hari4579/precharge/final_pre/final_pre.kicad_pcb

## KiCad design final_pre/final_pre.kicad_pcb (2026-10-30)

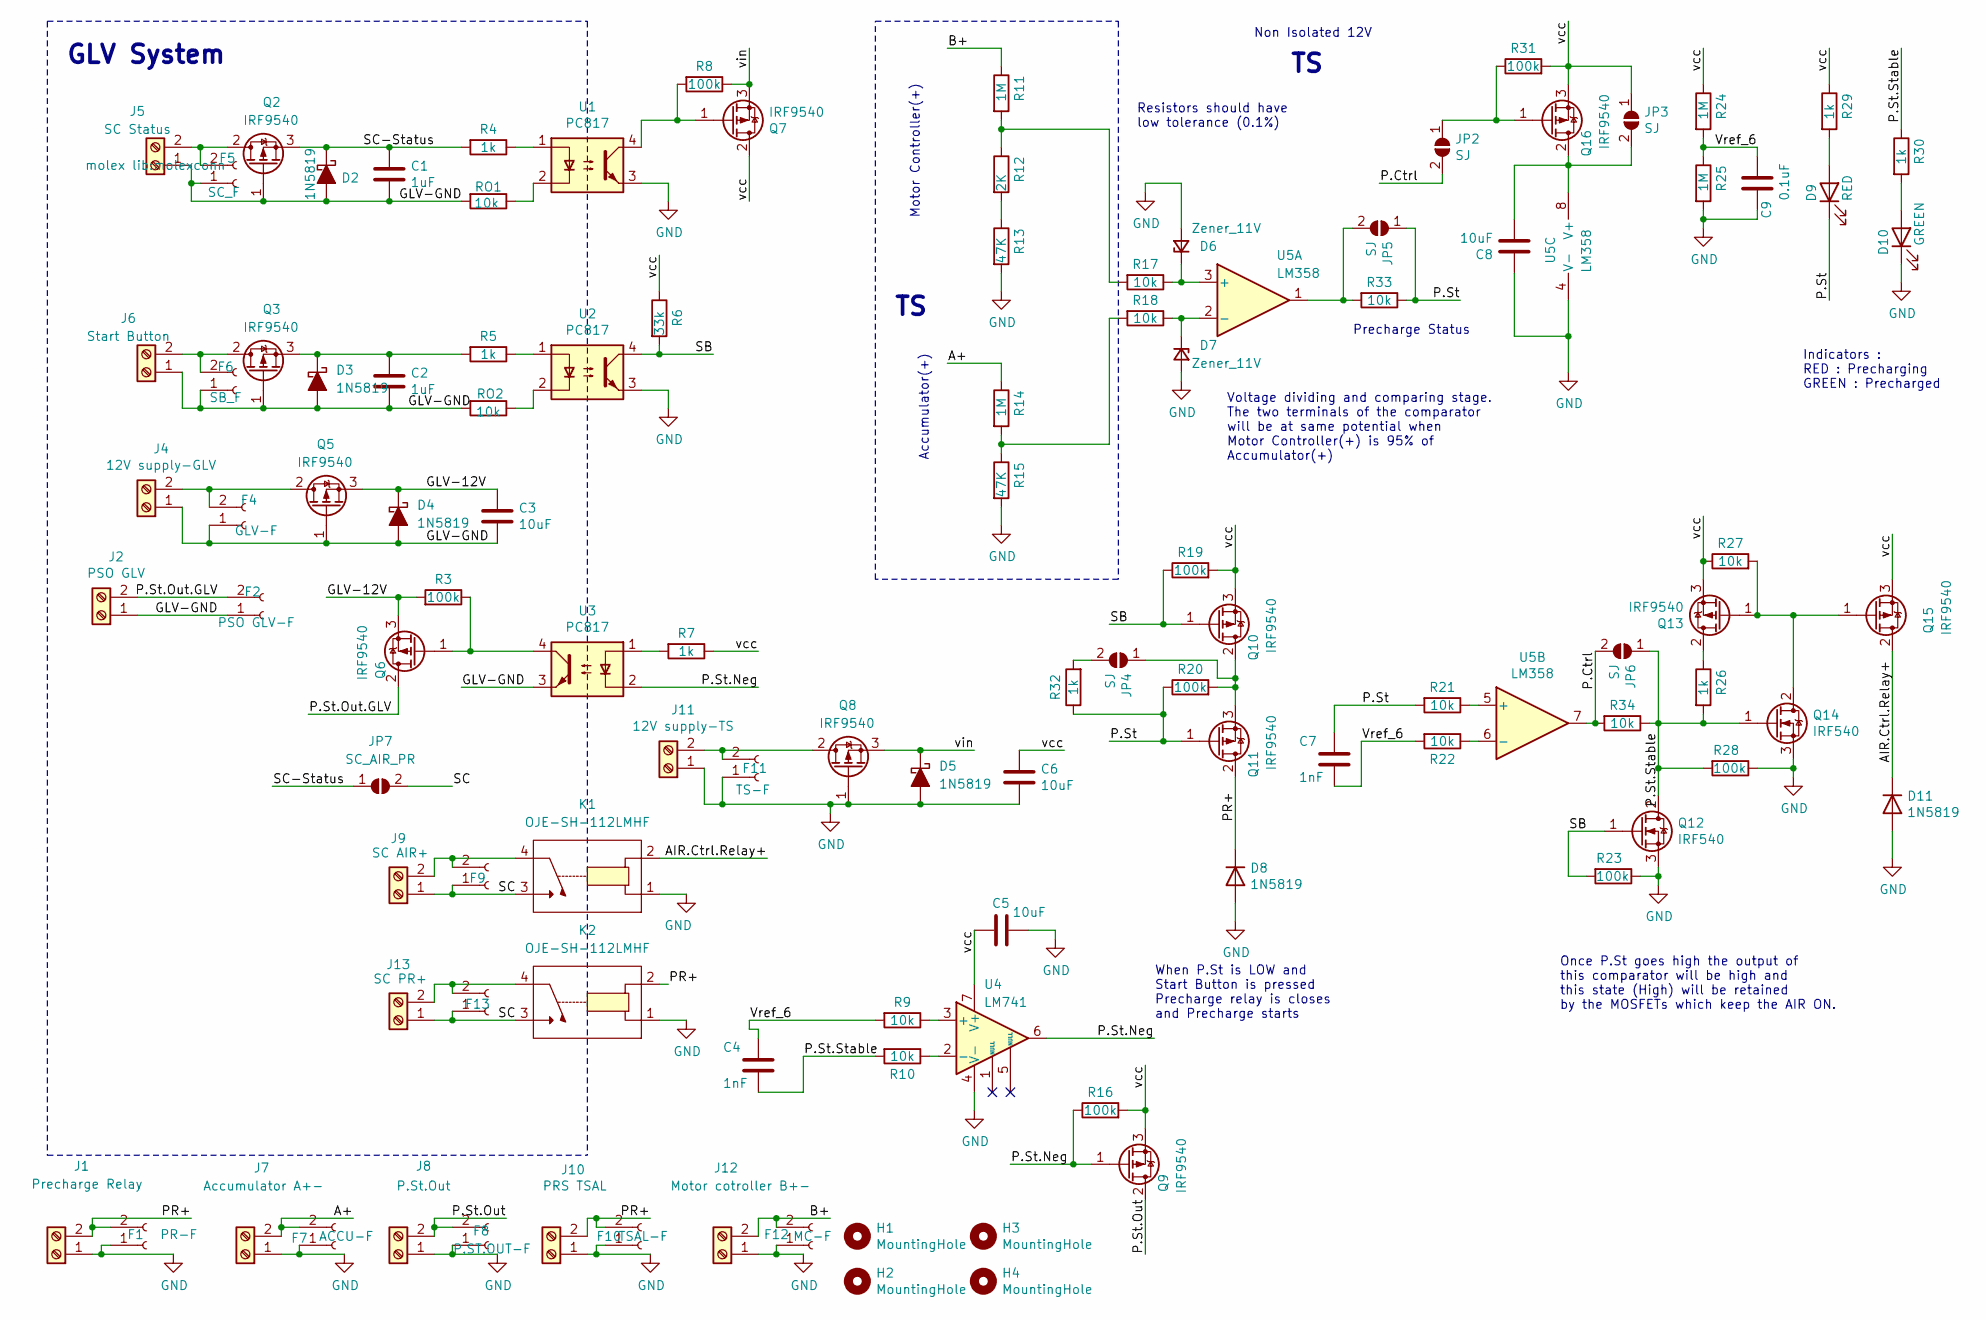
[picture p1: schematic final_pre.kicad_sch]

Parts:
C1, C2: 1uF; CP_Radial_D5.0mm_P2.50mm
C3, C5, C6, C8: 10uF; CP_Radial_D5.0mm_P2.50mm
C4, C7: 1nF; CP_Radial_D5.0mm_P2.50mm
C9: 0.1uF; CP_Radial_D5.0mm_P2.50mm
D2, D3, D4, D5, D8, D11: 1N5819; D_DO-41_SOD81_P10.16mm_Horizontal
D6, D7: Zener_11V; D_DO-41_SOD81_P10.16mm_Horizontal
D9: RED; LED_D5.0mm
D10: GREEN; LED_D5.0mm
F1: PR-F; PinSocket_1x02_P2.54mm_Vertical
F2: PSO GLV-F; PinSocket_1x02_P2.54mm_Vertical
F4: GLV-F; PinSocket_1x02_P2.54mm_Vertical
F5: SC_F; PinSocket_1x02_P2.54mm_Vertical
F6: SB_F; PinSocket_1x02_P2.54mm_Vertical
F7: ACCU-F; PinSocket_1x02_P2.54mm_Vertical
F8: P.ST.OUT-F; PinSocket_1x02_P2.54mm_Vertical
F9: SC AIR-F; PinSocket_1x02_P2.54mm_Vertical
F10: TSAL-F; PinSocket_1x02_P2.54mm_Vertical
F11: TS-F; PinSocket_1x02_P2.54mm_Vertical
F12: MC-F; PinSocket_1x02_P2.54mm_Vertical
F13: PC AIR-F; PinSocket_1x02_P2.54mm_Vertical
H1, H2, H3, H4: MountingHole; MountingHole_3mm
J1: Precharge Relay; molexconn
J2: PSO GLV; molexconn
J4: 12V supply-GLV; molexconn
J5: SC Status; molexconn
J6: Start Button; molexconn
J7: Accumulator A+-; molexconn
J8: P.St.Out; molexconn
J9: SC AIR+; molexconn
J10: PRS TSAL; molexconn
J11: 12V supply-TS; molexconn
J12: Motor cotroller B+-; molexconn
J13: SC PR+; molexconn
JP2, JP3, JP4, JP5, JP6: SJ; SolderJumper-2_P1.3mm_Open_TrianglePad1.0x1.5mm
JP7: SC_AIR_PR; SolderJumper-2_P1.3mm_Open_TrianglePad1.0x1.5mm
K1, K2: OJE-SH-112LMHF
Q2, Q3, Q5, Q6, Q7, Q8, Q9, Q10, Q11, Q13, Q15, Q16: IRF9540; TO-220-3_Vertical
Q12, Q14: IRF540; TO-220-3_Vertical
R3, R8, R16, R19, R20, R23, R28, R31: 100k; R_Axial_DIN0207_L6.3mm_D2.5mm_P10.16mm_Horizontal
R4, R5, R7, R26, R29, R30, R32: 1k; R_Axial_DIN0207_L6.3mm_D2.5mm_P10.16mm_Horizontal
R6: 33k; R_Axial_DIN0207_L6.3mm_D2.5mm_P10.16mm_Horizontal
R9, R10, R17, R18, R21, R22, R27, R33, R34: 10k; R_Axial_DIN0207_L6.3mm_D2.5mm_P10.16mm_Horizontal
R11, R14, R24, R25: 1M; R_Axial_DIN0207_L6.3mm_D2.5mm_P10.16mm_Horizontal
R12: 2K; R_Axial_DIN0207_L6.3mm_D2.5mm_P10.16mm_Horizontal
R13, R15: 47K; R_Axial_DIN0207_L6.3mm_D2.5mm_P10.16mm_Horizontal
RO1, RO2: 10k; R_Axial_DIN0207_L6.3mm_D2.5mm_P10.16mm_Horizontal
U1, U2, U3: PC817; DIP-4_W7.62mm
U4: LM741; DIP-8_W7.62mm
U5: LM358; DIP-8_W7.62mm

Connections:
/A+: F7.2, J7.2, R14.1
/AIR.Ctrl.Relay+: D11.1 (K), K1.2, Q15.2 (D)
/B+: F12.2, J12.2, R11.1
/GLV-12V: C3.1, D4.1 (K), Q5.3 (S), Q6.3 (S), R3.2
/GLV-GND: C1.2, C2.2, C3.2, D2.2 (A), D3.2 (A), D4.2 (A), F2.1, F4.1, F5.1, F6.1, J2.1, J4.1, J5.1, J6.1, Q2.1 (G), Q3.1 (G), Q5.1 (G), RO1.2, RO2.2, U3.3
/P.Ctrl: JP2.2 (B), JP6.2 (B), R34.2, U5.7
/P.St: C7.1, D9.1 (K), JP5.1 (A), Q11.1 (G), R20.1, R21.2, R32.1, R33.1
/P.St.Neg: Q9.1 (G), R16.1, U3.2, U4.6
/P.St.Out: F8.2, J8.2, Q9.2 (D)
/P.St.Out.GLV: F2.2, J2.2, Q6.2 (D)
/P.St.Stable: C4.2, JP6.1 (A), Q12.2 (D), Q14.1 (G), R10.2, R26.2, R28.2, R30.1, R34.1
/PR+: D8.1 (K), F1.2, F10.2, J1.2, J10.2, K2.2, Q11.2 (D)
/SB: Q10.1 (G), Q12.1 (G), R6.2, R19.1, R23.2, U2.4
/SC: F9.1, F13.1, J9.1, J13.1, JP7.2 (B), K1.3, K2.3
/SC-Status: C1.1, D2.1 (K), JP7.1 (A), Q2.3 (S), R4.2
/Vref_6: C4.1, C7.2, C9.1, R9.2, R22.2, R24.2, R25.1
/vcc: C5.1, C6.1, JP3.1 (A), Q7.2 (D), Q9.3 (S), Q10.3 (S), Q13.3 (S), Q15.3 (S), Q16.3 (S), R6.1, R7.1, R16.2, R19.2, R24.1, R27.1, R29.1, R31.2, U4.7 (V+)
/vin: D5.1 (K), Q7.3 (S), Q8.3 (S), R8.1
GND: C5.2, C6.2, C8.1, C9.2, D5.2 (A), D6.2 (A), D7.2 (A), D8.2 (A), D10.1 (K), D11.2 (A), F1.1, F7.1, F8.1, F10.1, F11.1, F12.1, J1.1, J7.1, J8.1, J10.1, J11.1, J12.1, K1.1, K2.1, Q8.1 (G), Q12.3 (S), Q14.3 (S), R13.2, R15.2, R23.1, R25.2, R28.1, U1.3, U2.3, U4.4 (V-), U5.4 (V-)
unnamed: C2.1, D3.1 (K), Q3.3 (S), R5.2
unnamed: D6.1 (K), R17.1, U5.3 (+)
unnamed: D7.1 (K), R18.1, U5.2 (-)
unnamed: D9.2 (A), R29.2
unnamed: D10.2 (A), R30.2
unnamed: F4.2, J4.2, Q5.2 (D)
unnamed: F5.2, J5.2, Q2.2 (D)
unnamed: F6.2, J6.2, Q3.2 (D)
unnamed: F9.2, J9.2, K1.4
unnamed: F11.2, J11.2, Q8.2 (D)
unnamed: F13.2, J13.2, K2.4
unnamed: JP2.1 (A), Q16.1 (G), R31.1
unnamed: C8.2, JP3.2 (B), Q16.2 (D), U5.8 (V+)
unnamed: JP4.1 (A), Q10.2 (D), Q11.3 (S), R20.2
unnamed: JP4.2 (B), R32.2
unnamed: JP5.2 (B), R33.2, U5.1
unnamed: Q6.1 (G), R3.1, U3.4
unnamed: Q7.1 (G), R8.2, U1.4
unnamed: Q13.2 (D), R26.1
unnamed: Q13.1 (G), Q14.2 (D), Q15.1 (G), R27.2
unnamed: R4.1, U1.1
unnamed: R5.1, U2.1
unnamed: R7.2, U3.1
unnamed: R11.2, R12.1, R17.2
unnamed: R12.2, R13.1
unnamed: R14.2, R15.1, R18.2
unnamed: RO1.1, U1.2
unnamed: RO2.1, U2.2
unnamed: R9.1, U4.3 (+)
unnamed: R10.1, U4.2 (-)
unnamed: R21.1, U5.5 (+)
unnamed: R22.1, U5.6 (-)

Notes on the sheet:
Precharge Status
Once P.St goes high the output of this comparator will be high and this state (High) will be retained by the MOSFETs which keep the AIR ON.
Indicators : RED : Precharging GREEN : Precharged
Accumulator(+)
Resistors should have low tolerance (0.1%)
Non Isolated 12V
GLV System
When P.St is LOW and Start Button is pressed Precharge relay is closes and Precharge starts
Motor Controller(+)
Voltage dividing and comparing stage. The two terminals of the comparator will be at same potential when Motor Controller(+) is 95% of Accumulator(+)

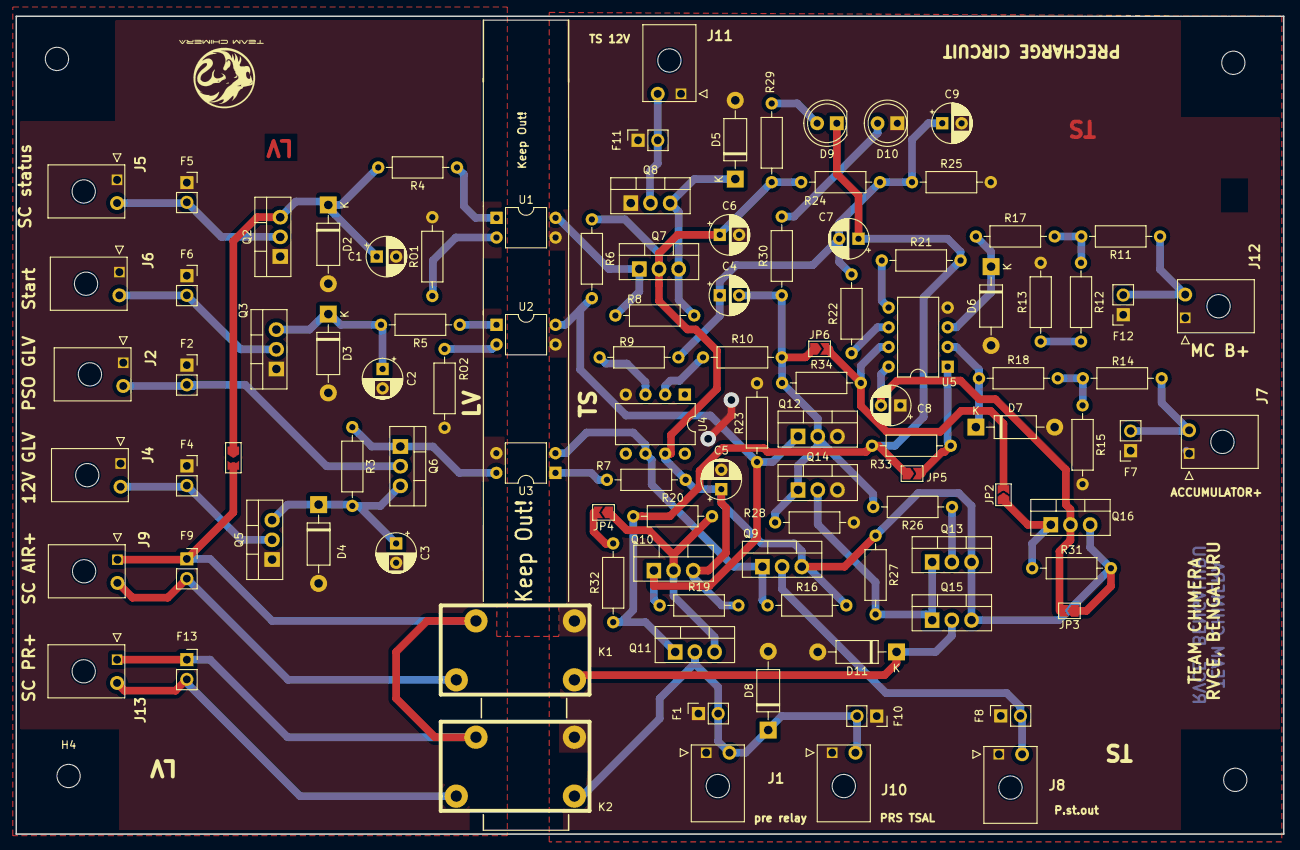
[picture p2: board final_pre.kicad_pcb from above]

Board: 2 copper layers, 163.5 x 105.5 mm, 108 parts (0 on the bottom side), 51 nets.
